Sagarpillai/squarbie/README.md

# Squarbie

A square take on Hack Club's Starbie desk pet. XIAO ESP32-C3, 0.96" SSD1306 OLED, MPU6050 (tilt/shake), DHT11 (temp/humidity), and 2 Cherry MX keys.

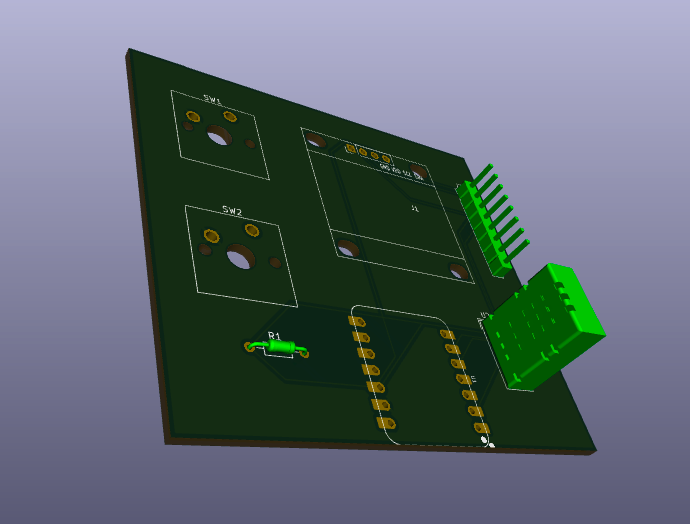
[picture p1: images/3d-angle.png]
3D render


| PCB | 3D (top) |
| --- | --- |
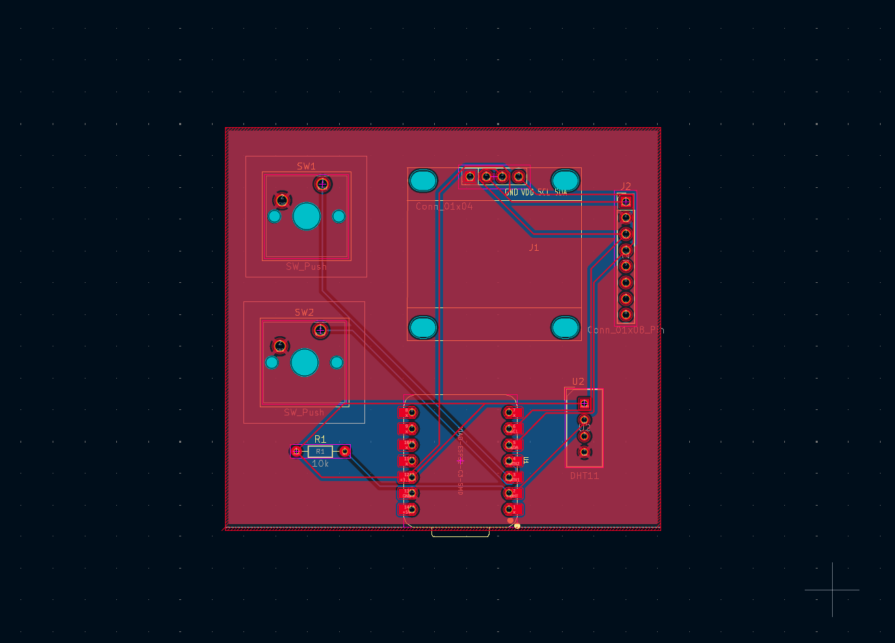
[picture p2: images/pcb.png]
PCB
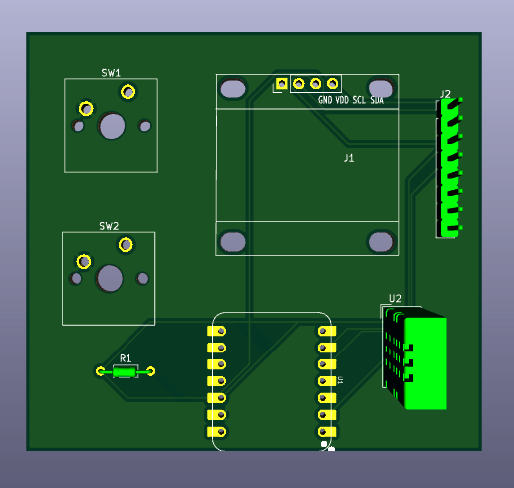
[picture p3: images/3d-top.png]
3D top
|  |  |

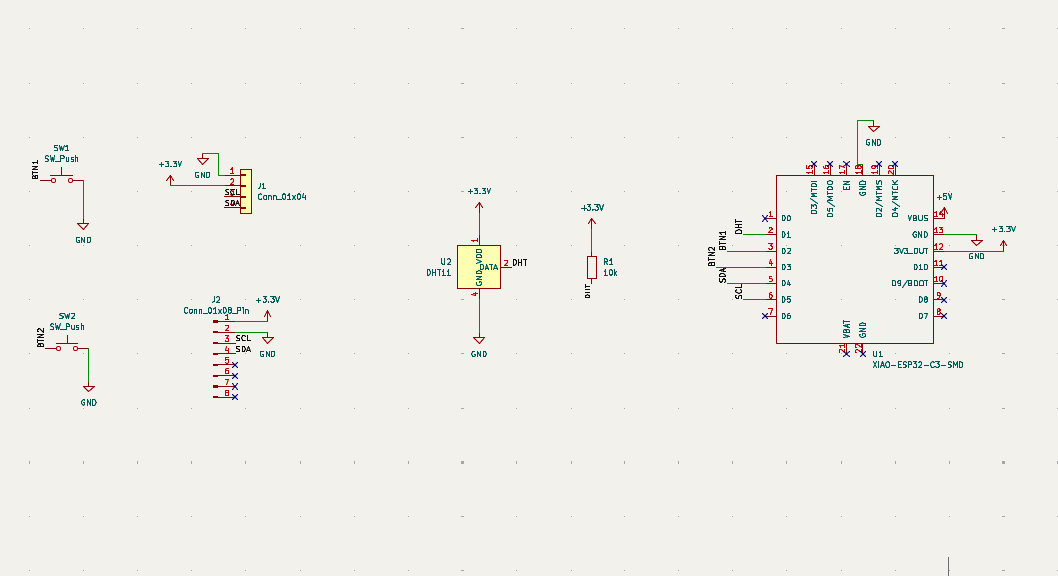
[picture p4: images/schematic.png]
Schematic


## Files
- `Starbie1.kicad_pro`, `.kicad_sch`, `.kicad_pcb`: KiCad 10 project
- `lib/`: care-package symbols and footprints
- `gerbers.zip`: fabrication files
- `BOM.md`: parts list

Built for Hack Club Half Life, Week 1.

## Firmware
`Firmware/Starbie/Starbie.ino` is the Starbie starter sketch from [SharKingStudios/Starbie](https://github.com/SharKingStudios/Starbie). Squarbie uses the same pin mapping, so it runs unmodified.
