Sagarpillai/squarbie/BOM.md

# Squarbie – bill of materials

<!-- Generated by Half Life from project cmuurh5yn09s901sm8c3y0xvg. Edits here are overwritten on the next sync. -->
<!-- Generated: 2026-10-11T07:22:35.282Z -->

> [!NOTE]
> This parts list is mirrored from [Half Life](https://halflife.hackclub.com). Editing it here will not change the platform's copy, and the next sync overwrites this file.

| Week | Tier | Parts funding |
| --- | --- | --- |
| Week 1 | Tier 1 | $30.00 |

| Part | What it's for | Qty | Unit | Total | Vendor |
| --- | --- | --- | --- | --- | --- |
| [Seeed Studio XIAO ESP32C3](https://robu.in/product/seeed-studio-xiao-esp32c3-tiny-mcu-board-with-wi-fi-and-ble-battery-charge-supported-power-efficiency-and-rich-interface/) | Main microcontroller (Wi-Fi/BLE, runs firmware) | 1 | $7.80 | $7.80 | [Robu.in](https://robu.in/product/seeed-studio-xiao-esp32c3-tiny-mcu-board-with-wi-fi-and-ble-battery-charge-supported-power-efficiency-and-rich-interface/) |
| [0.96" SSD1306 I2C OLED, 4-pin](https://robu.in/product/0-96-inch-i2c-iic-oled-lcd-module-4pin-with-vcc-gnd-white/) | Display for the pet | 1 | $2.28 | $2.28 | [Robu.in](https://robu.in/product/0-96-inch-i2c-iic-oled-lcd-module-4pin-with-vcc-gnd-white/) |
| [GY-521 MPU6050 module](https://www.amazon.in/Robocraze-MPU-6050-Gyroscope-Accelerometer-Arduino/dp/B07H3XH1TB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) | Tilt and shake detection | 1 | $2.79 | $2.79 | [Amazon.in](https://www.amazon.in/Robocraze-MPU-6050-Gyroscope-Accelerometer-Arduino/dp/B07H3XH1TB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) |
| [DHT11 sensor, bare 4-pin](https://www.amazon.in/Fiftronics-Temperature-Raspberry-3-3V-5-5V-Automation/dp/B0HKJLN3KQ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) | Temperature and humidity | 1 | $1.51 | $1.51 | [Amazon.in](https://www.amazon.in/Fiftronics-Temperature-Raspberry-3-3V-5-5V-Automation/dp/B0HKJLN3KQ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) |
| [Squarbie PCB, 2-layer FR-4, 5 pcs](https://jlcpcb.com) | The board itself | 1 | $4.00 | $4.00 | [JLCPCB](https://jlcpcb.com) |
| [Outemu MX-compatible switches](https://www.thecosmicbyte.com/product/outemu-mechanical-switches-for-swappable-keyboards-pack-of-20/) | The 2 buttons (SW1, SW2) | 2 | $1.50 | $3.00 | [Cosmic Byte](https://www.thecosmicbyte.com/product/outemu-mechanical-switches-for-swappable-keyboards-pack-of-20/) |
| **Parts subtotal** | — | — | — | **$21.38** | — |
| **Tax & shipping** | — | — | — | **$9.75** | — |
| **Total** | — | — | — | **$31.13** | — |

**$1.13 over the tier's funding.** Every tier gives a fixed amount for parts, so this needs cutting back or a higher tier.
