Sagarpillai/squarbie/Starbie1.kicad_pcb

## KiCad design Starbie1.kicad_pcb (2026-10-08)

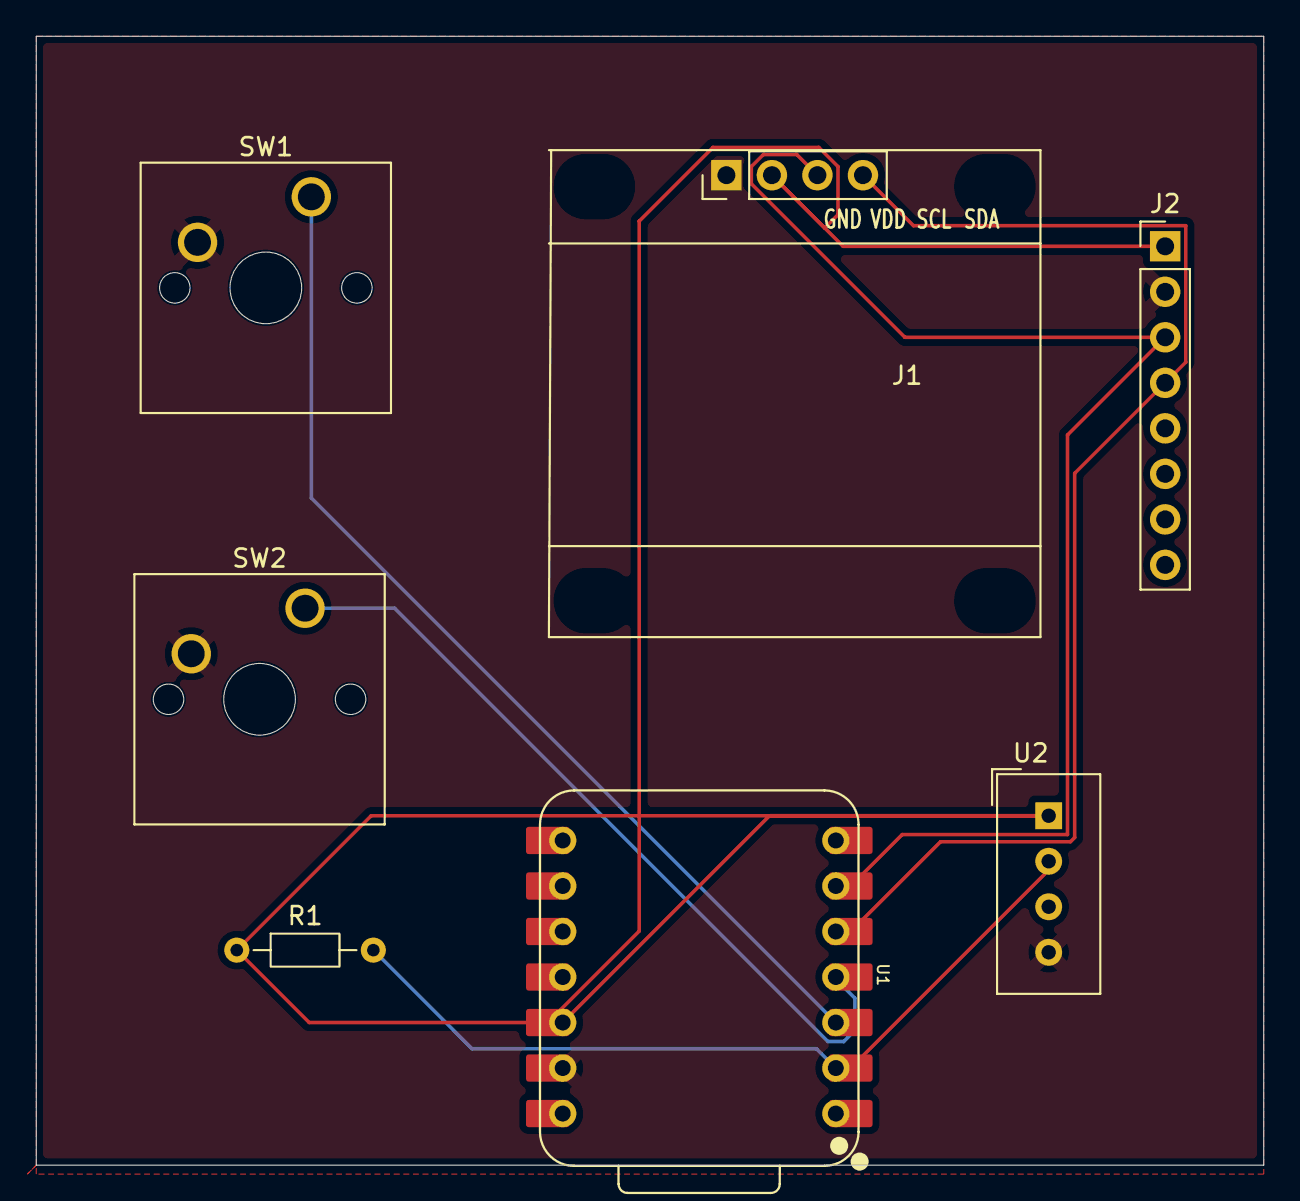
[picture p5: board Starbie1.kicad_pcb from above]

Board: 2 copper layers, 68.5 x 63.0 mm, 7 parts (0 on the bottom side), 7 nets.

Parts:
J1: Conn_01x04; Display_128x64_096_I2C
J2: Conn_01x08_Pin; PinHeader_1x08_P2.54mm_Vertical
R1: 10k; R_Axial_DIN0204_L3.6mm_D1.6mm_P7.62mm_Horizontal
SW1, SW2: SW_Push; SW_Cherry_MX_1.00u_PCB
U1: XIAO-ESP32-C3-SMD; XIAO-ESP32-C6-DIP
U2: DHT11; Aosong_DHT11_5.5x12.0_P2.54mm

Connections:
+3.3V: J1.2, J2.1, R1.1, U1.12 (3V3_OUT), U2.1 (VDD)
/BTN1: SW1.1, U1.3 (D2)
/BTN2: SW2.1, U1.4 (D3)
/DHT: R1.2, U1.2 (D1), U2.2 (DATA)
/SCL: J1.3, J2.3, U1.6 (D5)
/SDA: J1.4, J2.4, U1.5 (D4)
GND: J1.1, J2.2, SW1.2, SW2.2, U1.13 (GND), U2.4 (GND)
